jimbruges/workshop-racing-telemetry-unoq/hardware/3d-print/wheel-board.3mf

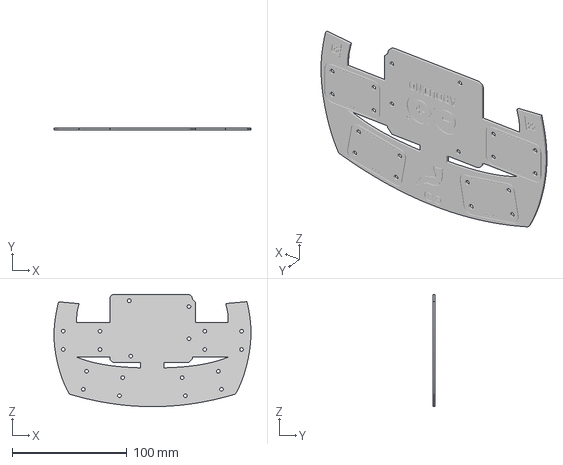
[picture p1: CAD file, 2026-10-19]
hardware/3d-print/wheel-board.3mf
171.8 x 1.60 x 97.8 mm
