jimbruges/workshop-racing-telemetry-unoq/hardware/jigs/spacer-jig.3mf

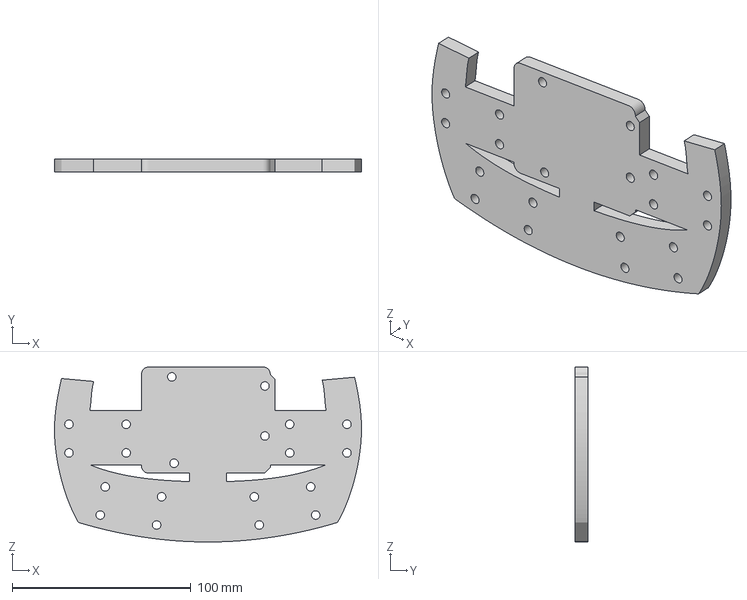
[picture p2: CAD file, 2026-10-19]
hardware/jigs/spacer-jig.3mf
171.7 x 7.40 x 97.8 mm
