jimbruges/workshop-racing-telemetry-unoq/hardware/laser-cut/wheel-board.dxf

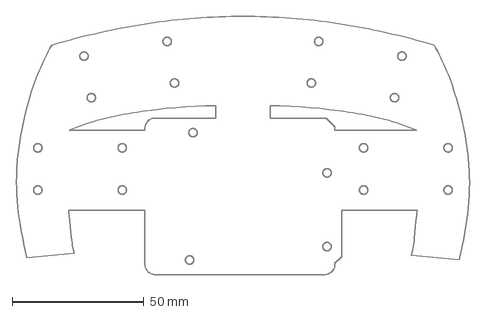
[picture p3: CAD file, 2026-10-19]
hardware/laser-cut/wheel-board.dxf
171.7 x 97.8 mm
