jimbruges/workshop-racing-telemetry-unoq/Sketch1.dxf

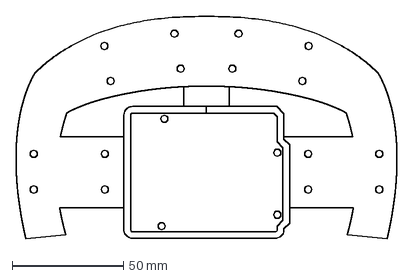
[picture p4: CAD file, 2026-08-27]
Sketch1.dxf
171.4 x 99.9 mm
