jimbruges/workshop-racing-telemetry-unoq/hardware/jigs/uno-q-jig.3mf

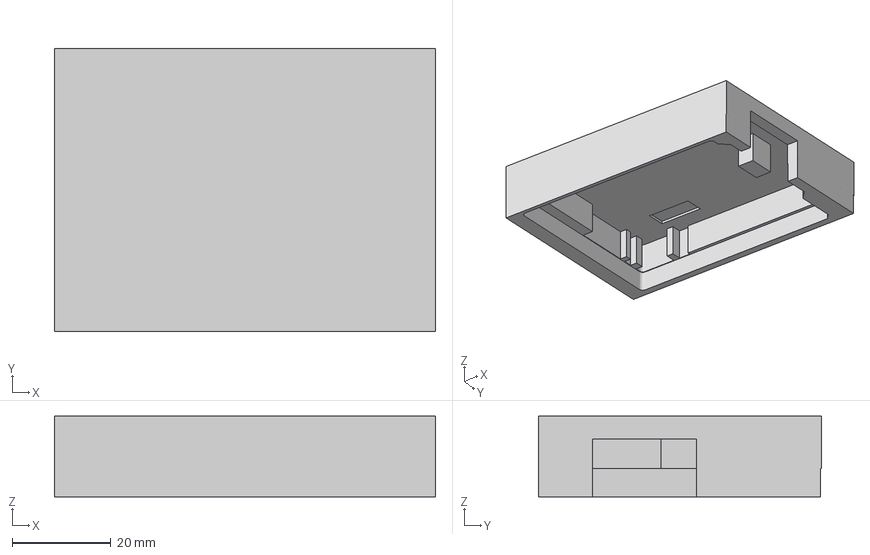
[picture p5: CAD file, 2026-10-19]
hardware/jigs/uno-q-jig.3mf
77.0 x 57.2 x 16.3 mm
