jimbruges/workshop-racing-telemetry-unoq/hardware/jigs/modulino-jig.3mf

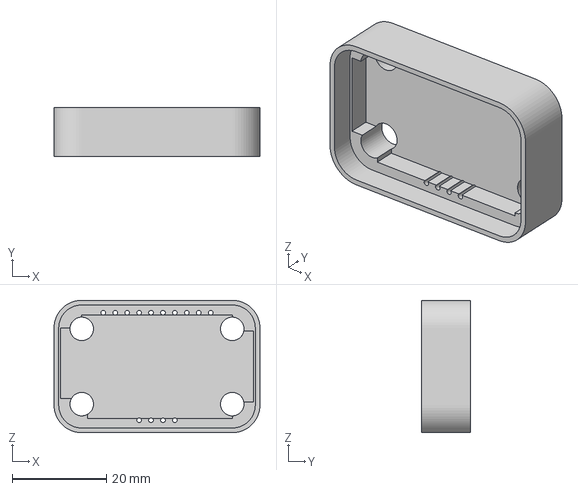
[picture p6: CAD file, 2026-10-19]
hardware/jigs/modulino-jig.3mf
43.8 x 10.5 x 28.2 mm
