jimbruges/workshop-racing-telemetry-unoq/(commit log)

2026-10-19 Prepare workshop for publication
    - Rewrite README: slides link, BOM, board options (JLCPCB/3D print/
    laser cut), jig-based assembly, App Lab ZIP import, custom model swap
    - Move hardware files into hardware/ with clean names; repack Gerbers
    flat and add DXF/SVG laser-cut outlines generated from the profile
    - Rename bundled model to python/model.eim so users can replace it
    with their own UNO Q deployment
    - Remove old Sketch1.dxf/Unnamed.svg and stop tracking .cache/ and
    __pycache__
2026-10-19 Ship runtime_config.json as the default steering calibration
